STFC-DDG/cosmic-ray-cube/Scintillator_geometry.pdf

300 mm
11.81 ”

10 mm
0.39 ”

230 mm
9.06 ”

60 mm
2.36 ”

1 mm
0.039 ”

1 mm
0.039 ”

300 mm
11.81 ”

60 mm
2.36 ”

230 mm
9.06 ”

60 mm
2.36 ”
