STFC-DDG/cosmic-ray-cube/PCB_Files/Control_board_V1-PC3860M1-Prototype/pc3860m1_BOM_Build_1.xlsx

TITLE: BILL OF MATERIALS
DESIGN: pc3860m1
BUILD No.: 1
DATE: 08/08/2023
NO. OF BOARDS REQD: 2 |  | Do Not Purchase - to be fitted at Rutherford Labs
All Components to be RoHS Compliant:
Please Read Comments Column:
Part Numbers may refer to Cut-tape, reel or other packaging options. Please purchase the packaging option best suited to your assembly process and this build:
Line No. | Part Number | Part Description | Ref Des | Board Qty | Build Qty | Use Exact Part | Use Equiv. Part | Equivalent Part Number | Comments
1 | Murata GRM155R71C104KA88J | 100nF SMD Capacitor, 0402, X7R Dielectric, 16V, 10% | C128-C131,C133-C185,C202-C209,C212,C216,C220,C224,C228,C232,C236,C240 | 73 | 146 |  |  |  | Available from DigiKey 490-6328-1-ND
2 | AVX 08055C474KAT2A | 470nF SMD 50V X7R Capacitor, 0805, 10% | C18-C25 | 8 | 16 |  |  |  | Available from Farnell 1657935
3 | Kemet C0805C105K5RACTU | 1uF X7R 50V SMD Capacitor, 0805, 10% | C1-C8,C17,C30,C50,C52,C54,C61,C251-C258 | 22 | 44 |  |  |  | Available from RS 802-9942
4 | Farnell 498-543 | 22pF NPO Capacitor, 0603, 50V, +/-5% | C243-C250 | 8 | 16 |  |  |  | -
5 | Murata GRM155R71H103KA88D | 10nF SMD Capacitor, 0402, X7R Dielectric, 50V, 10% | C26,C29,C56,C211,C215,C219,C223,C227,C231,C235,C239 | 11 | 22 |  |  |  | Available from Farnell 1828887
6 | AVX 0603ZD106MAT2A | 10uF SMD Capacitor, 0603, X5R Dielectric, 10V, 20% | C27,C28,C57,C186-C193,C214,C218,C222,C226,C230,C234,C238,C242 | 19 | 38 |  |  |  | Available from Farnell 1867954
7 | Yageo CC0402KRX7R8BB472 | 4.7nF SMD Capacitor, 0402, X7R Dielectric, 25V, 10% | C31-C38 | 8 | 16 |  |  |  | Available from Farnell 3019317
8 | Taiyo Yuden EMK325ABJ107MM-T | 100uF X5R 16V Ceramic Capacitor, 1210, 20% | C39 | 1 | 2 |  |  |  | Available from DigiKey 587-3152-1-ND
9 | AVX 0603YC105KAT2A | 1uF SMD Capacitor, 0603, X7R Dielectric, 16V, 10% | C40-C48,C132,C194-C201,C210,C213,C217,C221,C225,C229,C233,C237,C241 | 27 | 54 |  |  |  | Available from Farnell 1658870
10 | AVX-KYOCERA TAJC476K016R | 47uF SMD 16V Tantalum Capacitor, Case Size C, 10% | C49 | 1 | 2 |  |  |  | Available from Farnell 197-324
11 | Farnell 498-798 | 10uF SMD Tantalum Capacitor, Case Size C, 20V, 10% | C51,C60 | 2 | 4 |  |  |  | -
12 | AVX-KYOCERA TAJA105K016R | 1uF SMD 16V Capacitor, Case Size A, 10% | C53 | 1 | 2 |  |  |  | Available from Farnell 498-701
13 | Kemet C0805C104K5RAC | 100nF SMD Capacitor, 0805, X7R Dielectric, 50V, 10% | C55,C58,C80-C95 | 18 | 36 |  |  |  | Available from RS 2644416
14 | Panasonic EEH-ZK1E561UP | 560uF 25V Aluminium Electrolytic Capacitor, ZKU Series, 20% | C59 | 1 | 2 |  |  |  | Available from DigiKey P124996CT-ND
15 | Murata GRM1555C1H331JA01D | 330pF 50V SMD Capacitor, 0402, +/-5%, C0G/NP0, GRM Series | C62 | 1 | 2 |  |  |  | Available from Farnell 8819653
16 | Sanyo 6TPE330MIL | 330uF Polymer Capacitor, 7343 Case, TPE Series Low ESR | C63 | 1 | 2 |  |  |  | Available from DigiKey P16250CT-ND
17 | Murata GRM21BR61A476ME15L | 47uF X5R 10V +/-20% SMD Capacitor, 0805 | C64-C79 | 16 | 32 |  |  |  | Available from Farnell 2611939
18 | Farnell 3019160 | 10pF NPO Capacitor, 0402, 5% | C9-C16 | 8 | 16 |  |  |  | -
19 | Micro Commercial Co MBR0540-TP | 500mA 40V SMD Schottky Power Diode | D1-D16 | 16 | 32 |  |  |  | Available from DigiKey MBR0540TPMSCT-ND
20 | Littelfuse 0453 005. | 5A Surface Mount Fuse, 453 Series | FS1 | 1 | 2 |  |  |  | -
21 | Abracon Coporation ASMPH-0603-1R5M-T | 1.5uH SMD Multilayer Chip Power Inductor 20% 900mA | L17 | 1 | 2 |  |  |  | Available from Digikey 535-12264-1-ND
22 | Murata Electronics BLM21BD222SN1L | 2.25K 250mA Ferrite Bead Inductor | L1-L8 | 8 | 16 |  |  |  | Available from DigiKey 490-9710-1-ND
23 | Murata LQH32CN470K53L | 47uH Chip Inductor, 10%, 170mA, 1210 | L9-L16 | 8 | 16 |  |  |  | Available from DigiKey 490-4063-1-ND
24 | Harwin M20-999 03 45 | Harwin Straight 3 pin Header | PL18,PL19 | 2 | 4 |  |  |  | Can be cut from M20-999 36 45
25 | Molex 22-05-1032 | Right-Angle 3 pin Header with friction lock | PL1-PL8 | 8 | 16 |  |  |  | Available from Farnell 9731016
26 | Molex 26-48-2036 | 3.96mm Pitch, 3 Way Right Angle Friction Lock Header, KK Series, PTH | PL20-PL35 | 16 | 32 |  |  |  | Available from Mouser 538-26-48-2036
27 | Harwin M20-999 02 45 | Harwin Straight 2 pin Header, 0.1 inch pitch | PL9-PL17 | 9 | 18 |  |  |  | Can be cut from M20-999 36 45
28 | Farnell 9239316 | 4K7 SMD Resistor, 0.063W, 0402, 1% | R121-R128 | 8 | 16 |  |  |  | -
29 | Multicomp MC00625W04021150K | 150K SMD Resistor, 0.063W, 0402, 1% | R138,R140,R142,R144,R146,R148,R150,R152 | 8 | 16 |  |  |  | Available from Farnell 1358100
30 | Panasonic ERJ2RKF2490X | 249R SMD Resistor, 0.1W, 0402, 1% | R153-R160 | 8 | 16 |  |  |  | Available from Farnell 2059120
31 | Multicomp MCSR04X1001FTL | 1K0 SMD Resistor, 0.063W, 0402, 1% | R1-R8,R75 | 9 | 18 |  |  |  | Available from Farnell 2073959
32 | Yageo RC0402FR-07100KL | 100K SMD Resistor, 0.063W, 0402, 1% | R25-R40 | 16 | 32 |  |  |  | Available from Farnell 9239472
33 | Yageo RC0603FR-0713KL | 13k0 SMD Resistor, 0.1W, 0603, 1%, 75V | R41 | 1 | 2 |  |  |  | Available from Farnell 3495737
34 | TE Connectivity CPF0603B40K2E1 | 40K2 SMD Resistor, +/-25ppm/Deg C,0.063W, 0603, 0.1%,50V | R42 | 1 | 2 |  |  |  | Available from Farnell 2331207
35 | Multicomp MCWR04X1000FTL | 100R SMD Resistor, 0.063W, 0402, 1% | R43-R50 | 8 | 16 |  |  |  | Available from Farnell 2447095
36 | Farnell 9331379 | 560K SMD Resistor, 0.063W, 0603, 1% | R67-R74 | 8 | 16 |  |  |  | -
37 | Farnell 1170731 | 280R SMD Resistor, 0.063W, 0603, 1% | R76 | 1 | 2 |  |  |  | -
38 | Farnell 9239120 | 120R SMD Resistor, 0.063W, 0402, 1% | R96 | 1 | 2 |  |  |  | -
39 | Multicomp MCMR04X1002FTL | 10K SMD Resistor, 0.063W, 0402, 1% | R9-R24,R51-R66,R77-R95,R129-R137,R139,R141,R143,R145,R147,R149,R151 | 67 | 134 |  |  |  | Available from Farnell 2072517
40 | Bourns 3266W-1-104LF | 100K, 3266W Variable Resistor, 0.25W | RV1-RV8 | 8 | 16 |  |  |  | Available from Farnell 9352660
41 | Farnell 9352759 | 5K0, 3266W Variable Resistor, 0.25W | RV9,RV10 | 2 | 4 |  |  |  | -
42 | NorComp 820BR02-213R001 | 2 Position Circular Connector Receptacle, Female Sockets Solder, 820B Series | SK1 | 1 | 2 |  |  |  | Available from DigiKey NOR1502-ND
43 | Keystone 5001 | Black Miniture Through Hole Mount Test Point | TP1-TP7 | 7 | 14 |  |  |  | Available from DigiKey 36-5001-ND
44 | Philips BC850B | General Purpose Switching NPN Transistor | TR1-TR8 | 8 | 16 |  |  |  | Available from Farnell 1081239
45 | Linear Technology LT1962EMS8-5 | 300mA Low Noise LDO Regulator, 5V | U1,U18 | 2 | 4 |  |  |  | -
46 | Analogue Devices ADP7105ACPZ-R7 | Low Noise LDO Adjustable Regulator with Soft Start, 20Vin, 1.22V to 19V out, 500mA | U19 | 1 | 2 |  |  |  | Available from Mouser 584-ADP7105ACPZ-R7
47 | Linear Technology LT3461AES6#TRMPBF | 3MHz Step-Up DC/DC Converter with Integrated Schottky | U2,U4,U6,U8,U10,U12,U14,U16 | 8 | 16 |  |  |  | Available from DigiKey 505-LT3461AES6#TRMPBFCT-ND
48 | STMicroelectronics TS391ILT | Low-Power Single Voltage Comparator | U20-U27 | 8 | 16 |  |  |  | Available from Farnell 1467689
49 | Microchip MCP33141-10-E/MS | 1Msps/500ksps, 12-Bit Single-Ended Input SAR ADC | U28-U35 | 8 | 16 |  |  |  | Available from Mouser 579-MCP33141-10-E/MS
50 | Linear Technology LT1807IS8#PBF | 325MHz, Dual, Rail-to-Rail Input and Output, Low Distortion, Low Noise Precision Op Amps | U3,U5,U7,U9,U11,U13,U15,U17 | 8 | 16 |  |  |  | Available from DigiKey LT1807IS8#PBF-ND
51 | Analog Devices ADP151ACPZ-1.8-R7 | LDO Voltage Regulator, Fixed 1.8 V/200mA out, 2.2V-5.5V in, 150mV drop | U36 | 1 | 2 |  |  |  | Available from Farnell 2727446
52 | Analog Devices REF195GSZ | 5V Voltage Reference, ROHS Compliant | U37 | 1 | 2 |  |  |  | Available from DigiKey REF195GSZ-ND
53 | Texas Instruments SN74LVC1G08DCKR | Single 2-Input Positive-AND Gate | U38-U43,U49-U54 | 12 | 24 |  |  |  | Available from Farnell 1287597
54 | Diodes Inc 74LVC1G11DW-7 | Single 3 Input Positive AND Gate | U44-U48,U55-U59 | 10 | 20 |  |  |  | Available from Farnell 1893824
55 | Linear Technology LT1962EMS8-3.3PBF | 300mA Low Noise LDO Regulator, 3V3 | U60 | 1 | 2 |  |  |  | Available from RS 919-9207
56 | NXP 74AHC1G08GW/T1 | Single 2-Input AND Gate | U61 | 1 | 2 |  |  |  | Available from Farnell 1085240
57 | Texas Instruments SN74LVC1G332DCKR | Single 3-Input Positive-OR Gate | U62-U69,U72,U73 | 10 | 20 |  |  |  | Available from Farnell 1494932
58 | Texas Instruments SN74LVC1G17DBVT | Single Schmitt-Trigger Buffer | U70 | 1 | 2 |  |  |  | Available from Farnell 1739722
59 | Nexperia USA Inc. 74LVCH1T45GW-Q100H | Dual Supply Translating Transceiver, 3-State | U71,U74 | 2 | 4 |  |  |  | Available from DigiKey 1727-74LVCH1T45GW-Q100HCT-ND
60 | Texas Instruments SN74LVC1G32DCKR | Single 2 - Input Positive OR Gate | U75 | 1 | 2 |  |  |  | Available from Farnell 1470880
61 | Texas Instruments SN74LVC1G74DCUR | Single Positive-Edge-Triggered D-Type Flip-Flop with Clear and Preset | U76,U77 | 2 | 4 |  |  |  | Available from Farnell 2295725
62 | Texas Instruments SN74LVC1G04DBVR | Single Inverter Gate | U78 | 1 | 2 |  |  |  | Available from Farnell 3006604
63 | Texas Instruments PTH12060WAD | 10A, 12V Input Non-Isolated Wide-Output Adjust Power Module, PTH | U79 | 1 | 2 |  |  |  | Available from Mouser 595-PTH12060WAD
64 | PJRC TEENSY40 | Teensy 4.0 Microcontroller | U80,U82 | 2 | 4 |  |  |  | Available from The Pi Hut SKU: 103087 - DO NOT PURCHASE
65 | Adafruit 5400 | ESP32 Feather V2.0 Microcontroller | U81 | 1 | 2 |  |  |  | Available from The Pi Hut ADA5400 - DO NOT PURCHASE
66 | Texas Instruments SN74AVC8T245PWR | 8-Bit Dual-Supply Bus Transceiver With Configurable Voltage Translation and 3-State Outputs | U83,U84 | 2 | 4 |  |  |  | Available from DigiKey 296-33827-5-ND
67 | Maxim Integrated / Analog Devices MAX13443EASA+ | +/-15kV ESD-Protected, +/-80V Fault-Protected, Fail-Safe RS-485/J1708 Transceiver | U85 | 1 | 2 |  |  |  | Available from Farnell 2511397
