STFC-DDG/cosmic-ray-cube/PCB_Files/SiPM_board-PC3867M1/pc3867p1_BOM_Build_1.xlsx

TITLE: BILL OF MATERIALS
DESIGN: pc3867p1
BUILD No.: 1
DATE: 09/08/2023
NO. OF BOARDS REQD: 10
All Components to be RoHS Compliant:
Please Read Comments Column:
Part Numbers may refer to Cut-tape, reel or other packaging options. Please purchase the packaging option best suited to your assembly process and this build:
Line No. | Part Number | Part Description | Ref Des | Board Qty | Build Qty | Use Exact Part | Use Equiv. Part | Equivalent Part Number | Comments
1 | Murata GRM155R71H103KA88D | 10nF SMD Capacitor, 0402, X7R Dielectric, 50V, 10% | C1-C4 | 4 | 40 |  |  |  | Available from Farnell 1828887
2 | Molex 22-05-1032 | Right-Angle 3 pin Header with friction lock | PL1 | 1 | 10 |  |  |  | Available from Farnell 9731016
3 | KOA RN73R1ETTP50R0F50 | 50R SMD Resistor, 0.0625W, 0402, 1%, 50V | R1-R3 | 3 | 30 |  |  |  | Available from Farnell 3544456
4 | OnSemi S10931-050P | C-Series SiPM Sensor, 6mm x 6mm 35um | U1 | 1 | 10 |  |  |  | Available from Farnell 2949095
5 | PC3867P1 | Cosmic Cube SIPM Board - Printed Circuit Board | - | 1 | 10 |  |  |  | -
