STFC-DDG/cosmic-ray-cube/3D_Print_Files/TubeCollet.stl

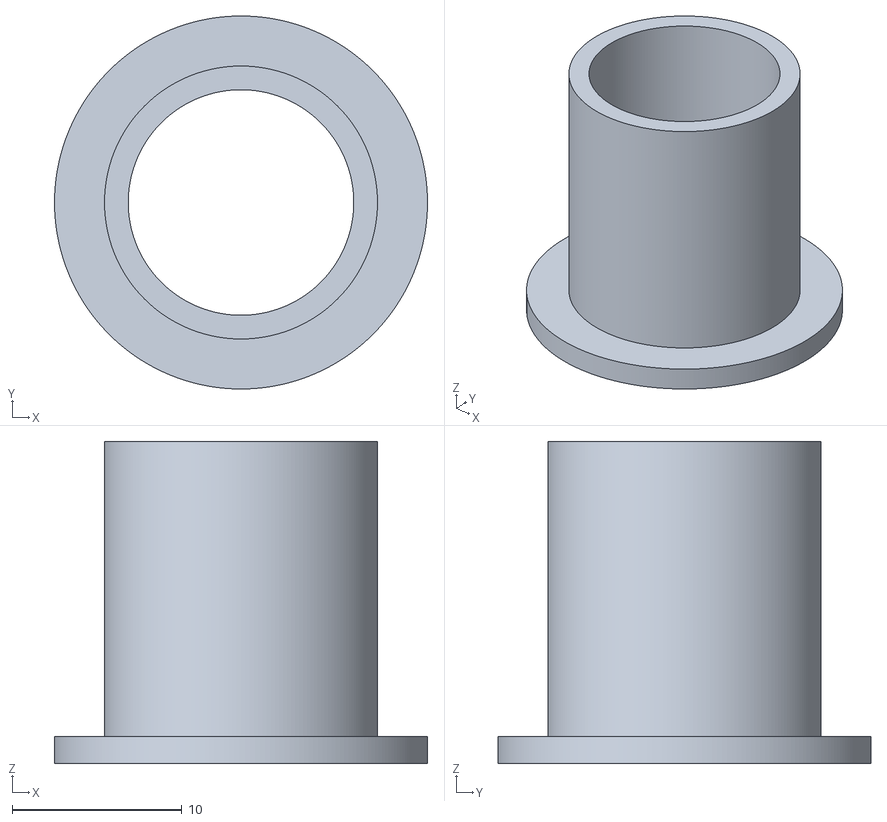
[picture p1: CAD file, 2024-02-02]
3D_Print_Files/TubeCollet.stl
22.0 x 22.0 x 19.0
