STFC-DDG/cosmic-ray-cube/3D_Print_Files/SiPM_clip.stl

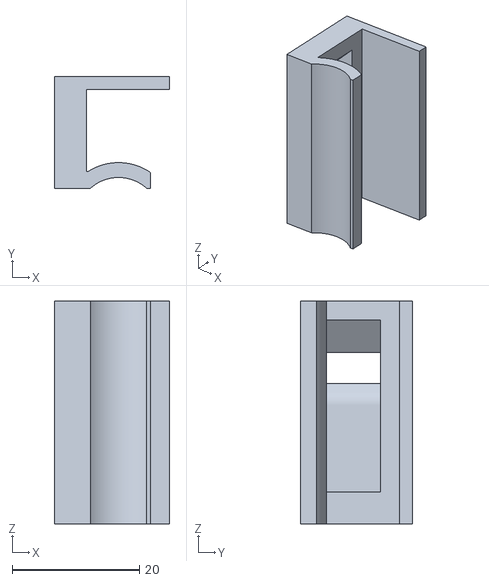
[picture p2: CAD file, 2024-02-02]
3D_Print_Files/SiPM_clip.stl
18.1 x 17.5 x 35.0
