STFC-DDG/cosmic-ray-cube/PCB_Files/Control_board_V1-PC3860M1-Prototype/pc3860m1_080823_schematic_A.pdf

## -TE-0208-011-1-A

### LT3461A

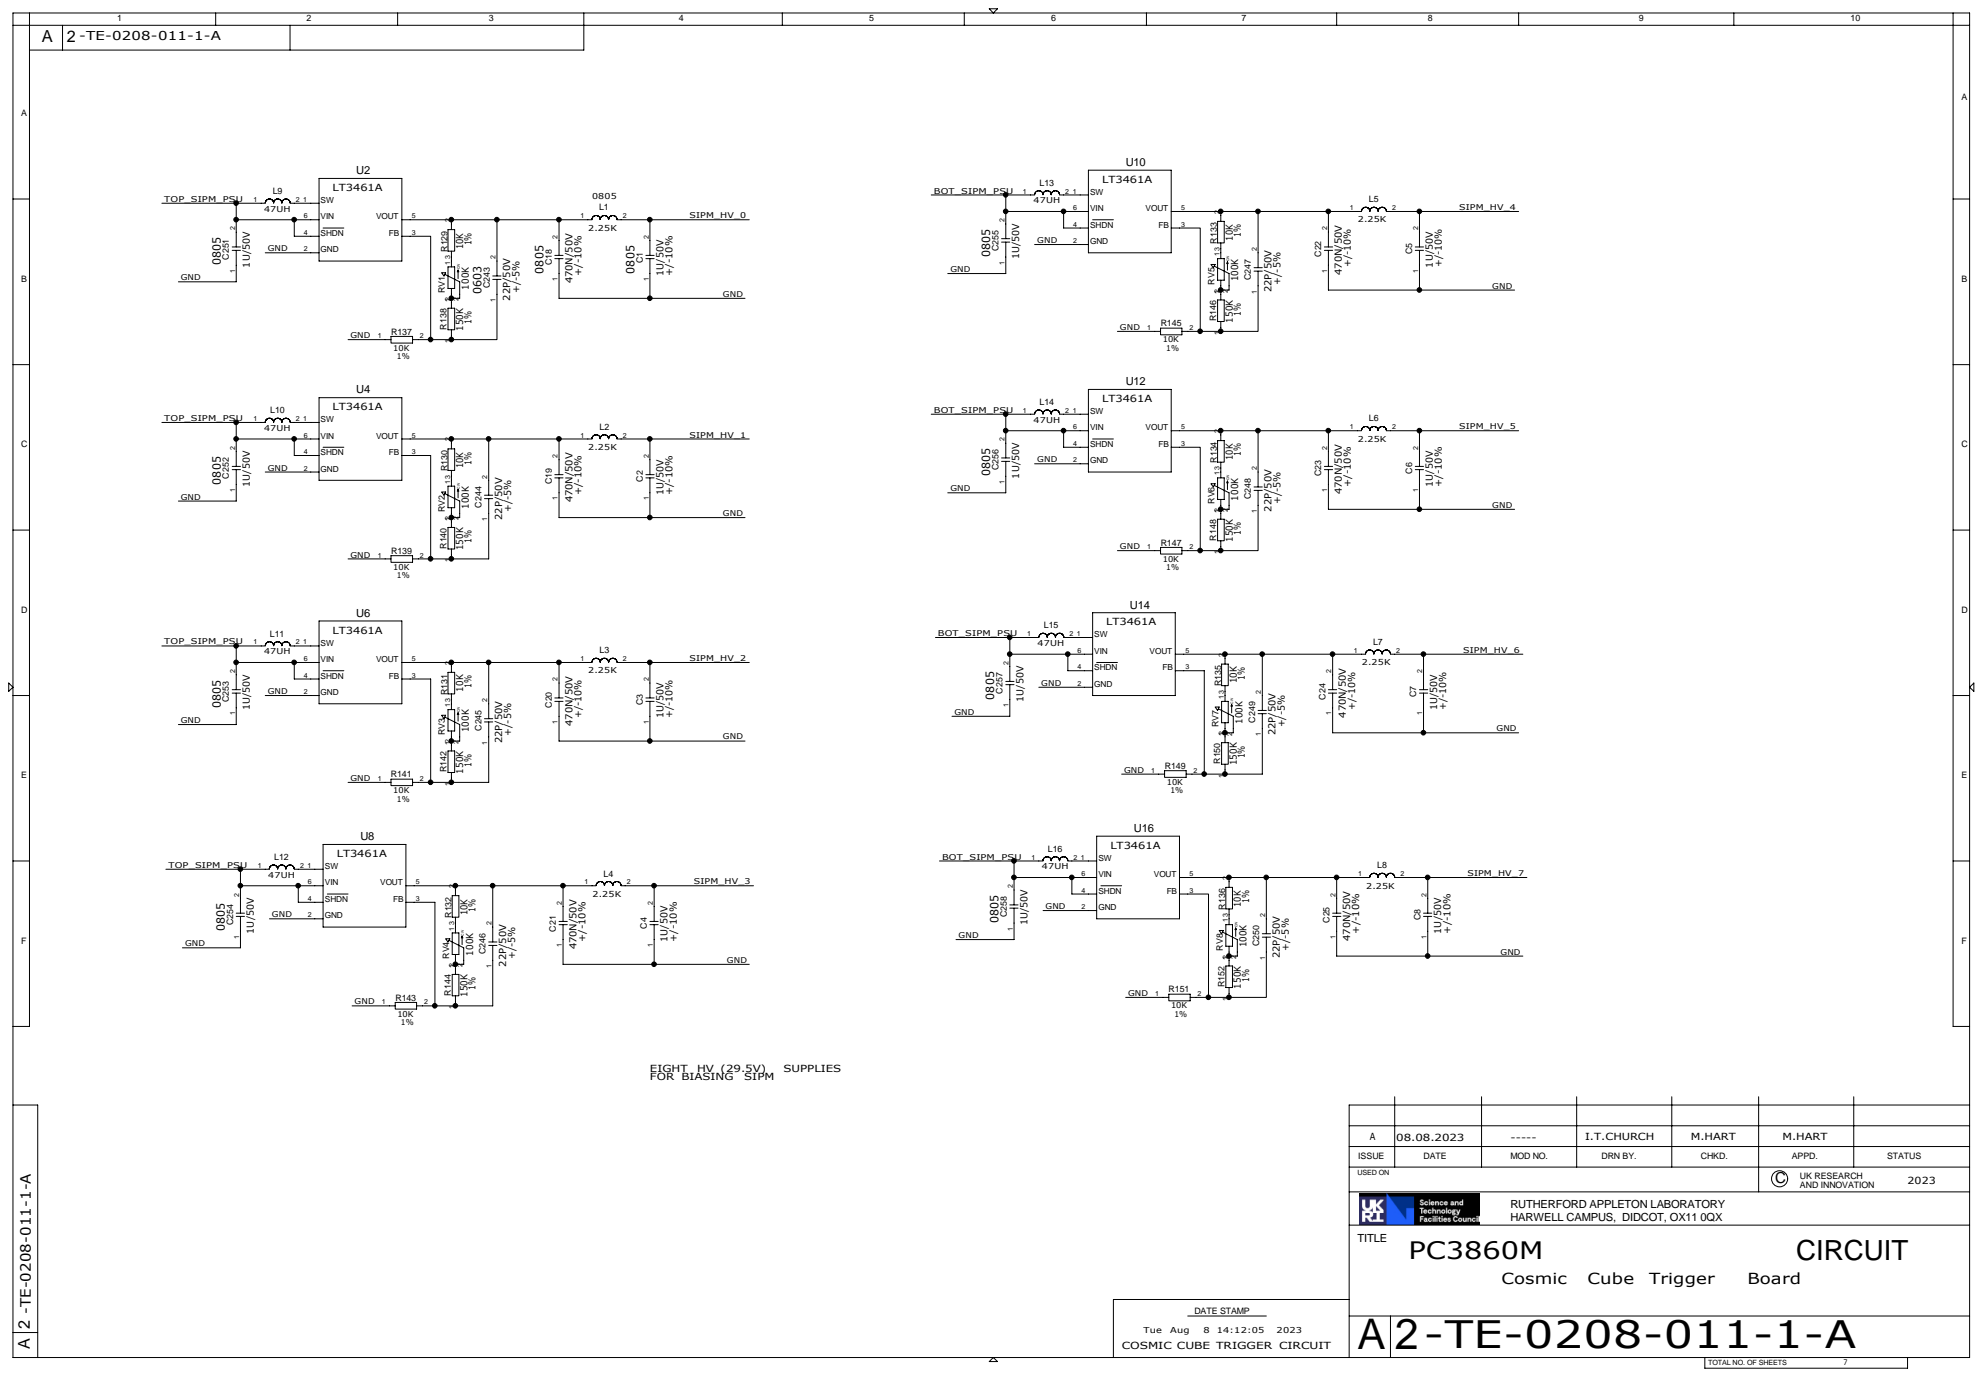
[picture p8: page 1]

COSMIC CUBE TRIGGER CIRCUIT

TOTAL NO. OF SHEETS

### TOP NORTH

### EVENT TRIGGER COMPARATORS

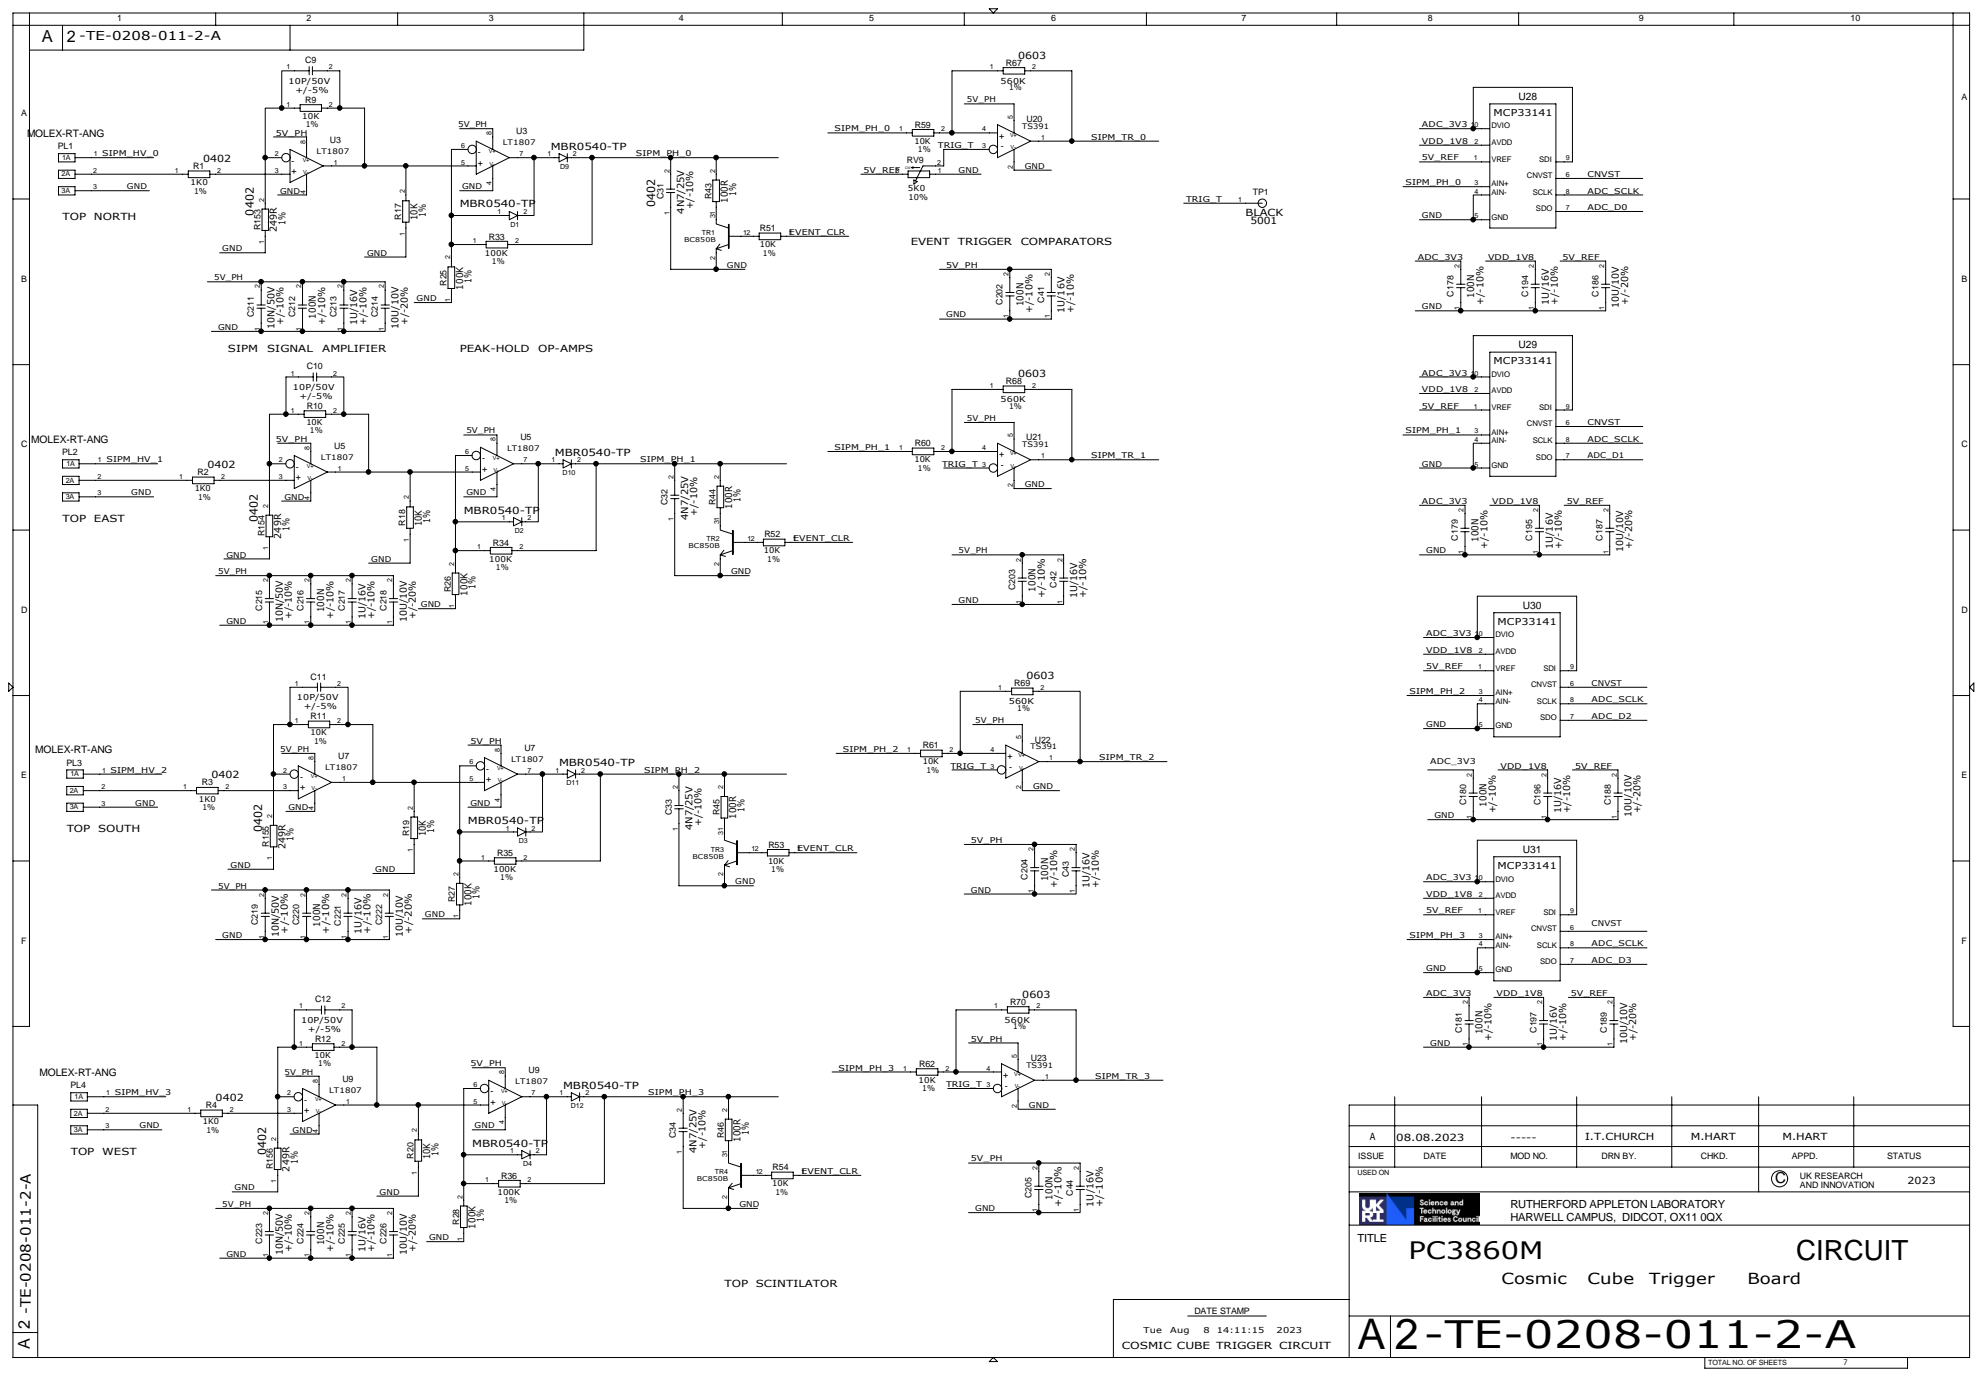
[picture p9: page 2]

### BOTTOM NORTH

## -TE-0208-011-3-A

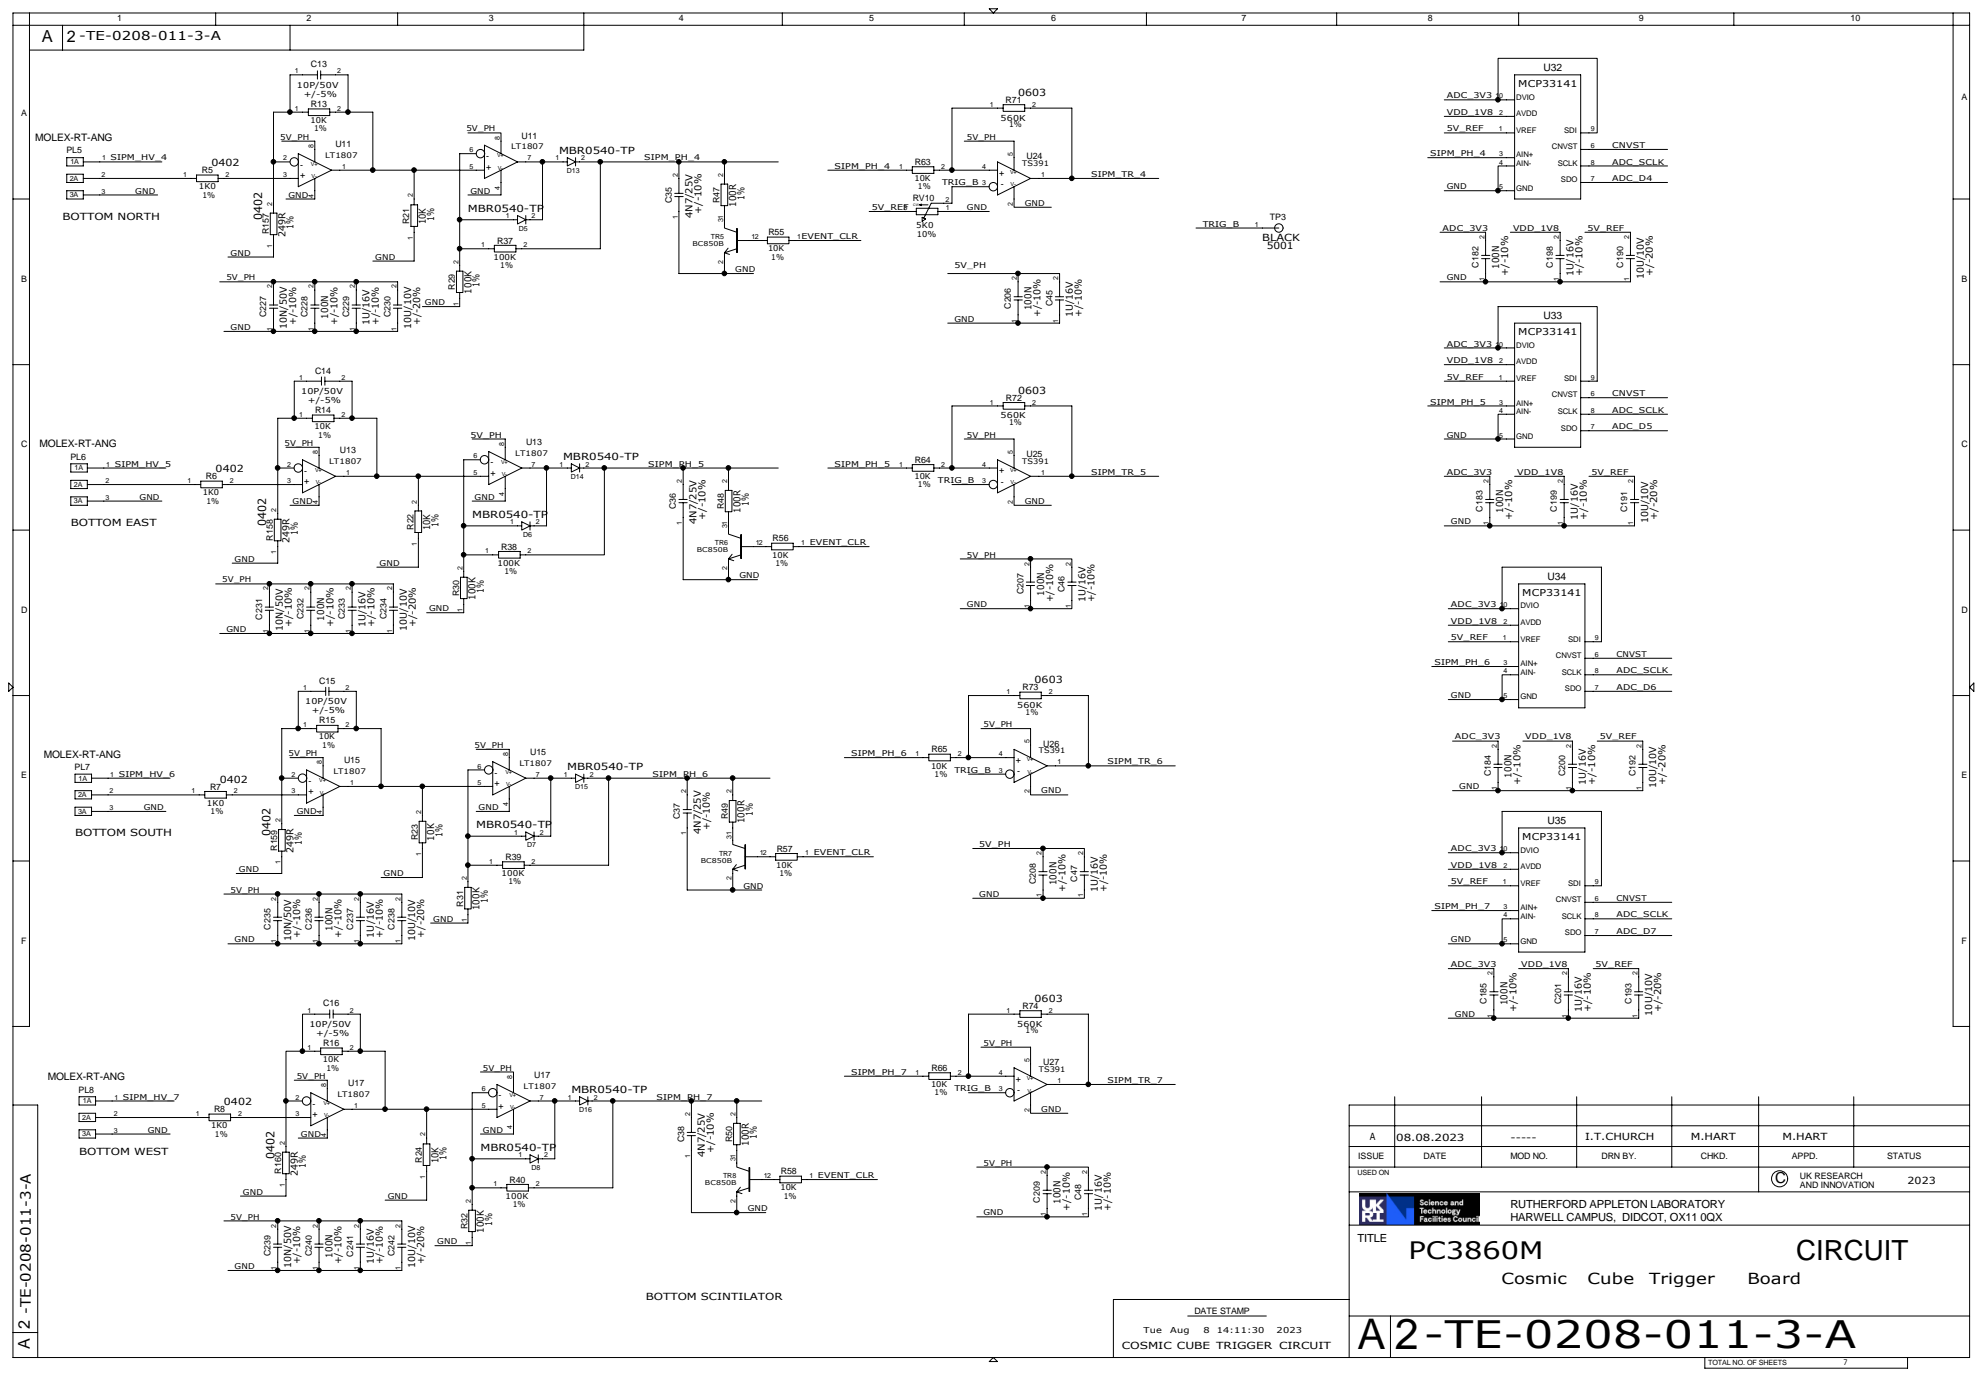
[picture p10: page 3]

0001 N

0000 N

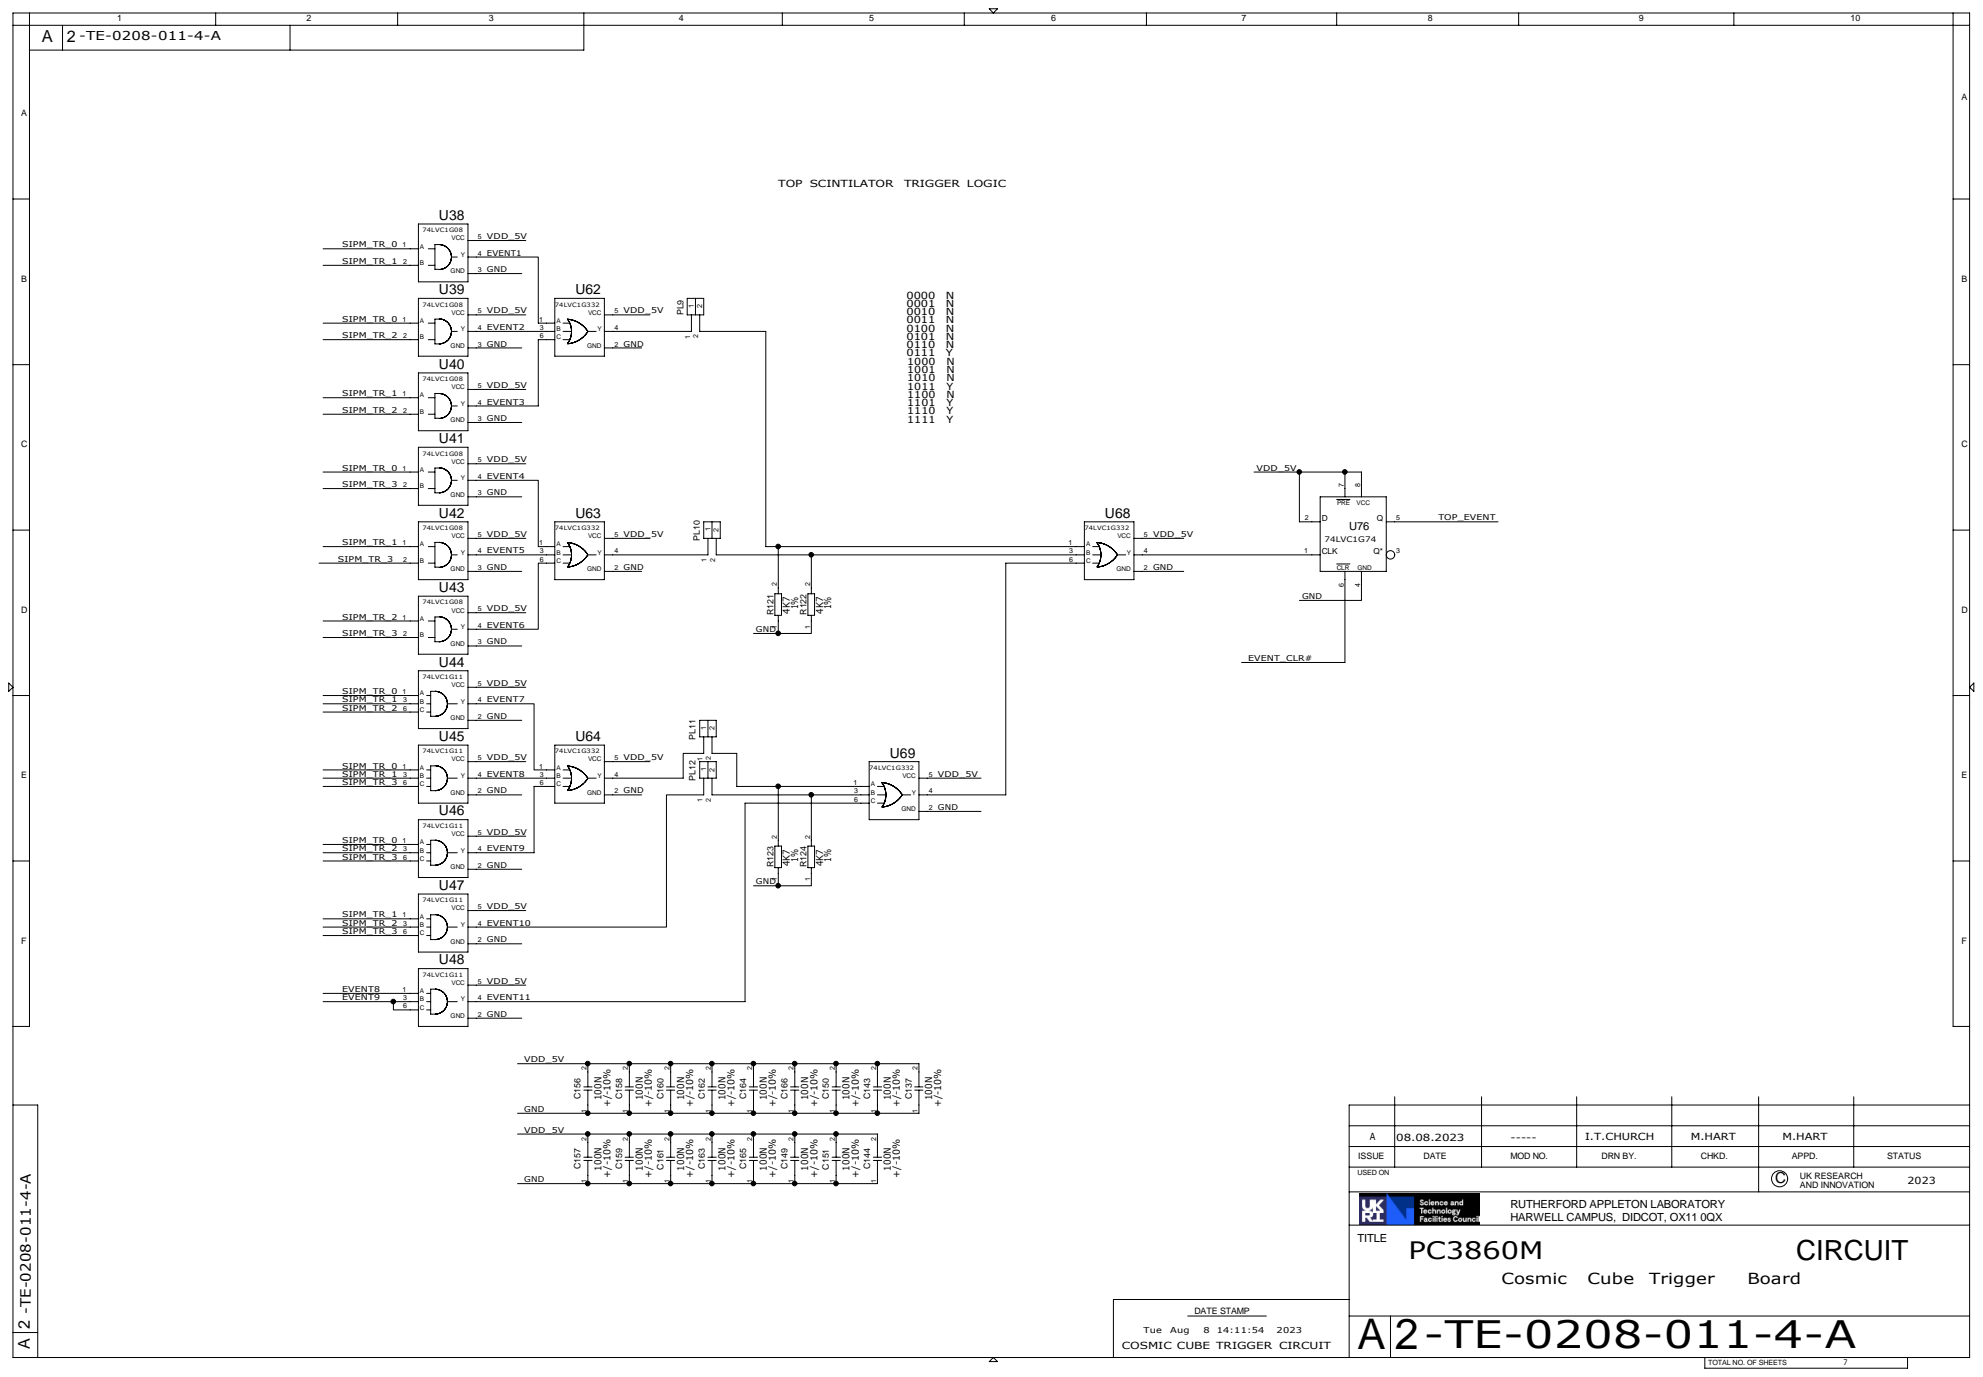
[picture p11: page 4]

TOP SCINTILATOR TRIGGER LOGIC

### BOTTOM SCINTILATOR TRIGGER LOGIC

## -TE-0208-011-5-A

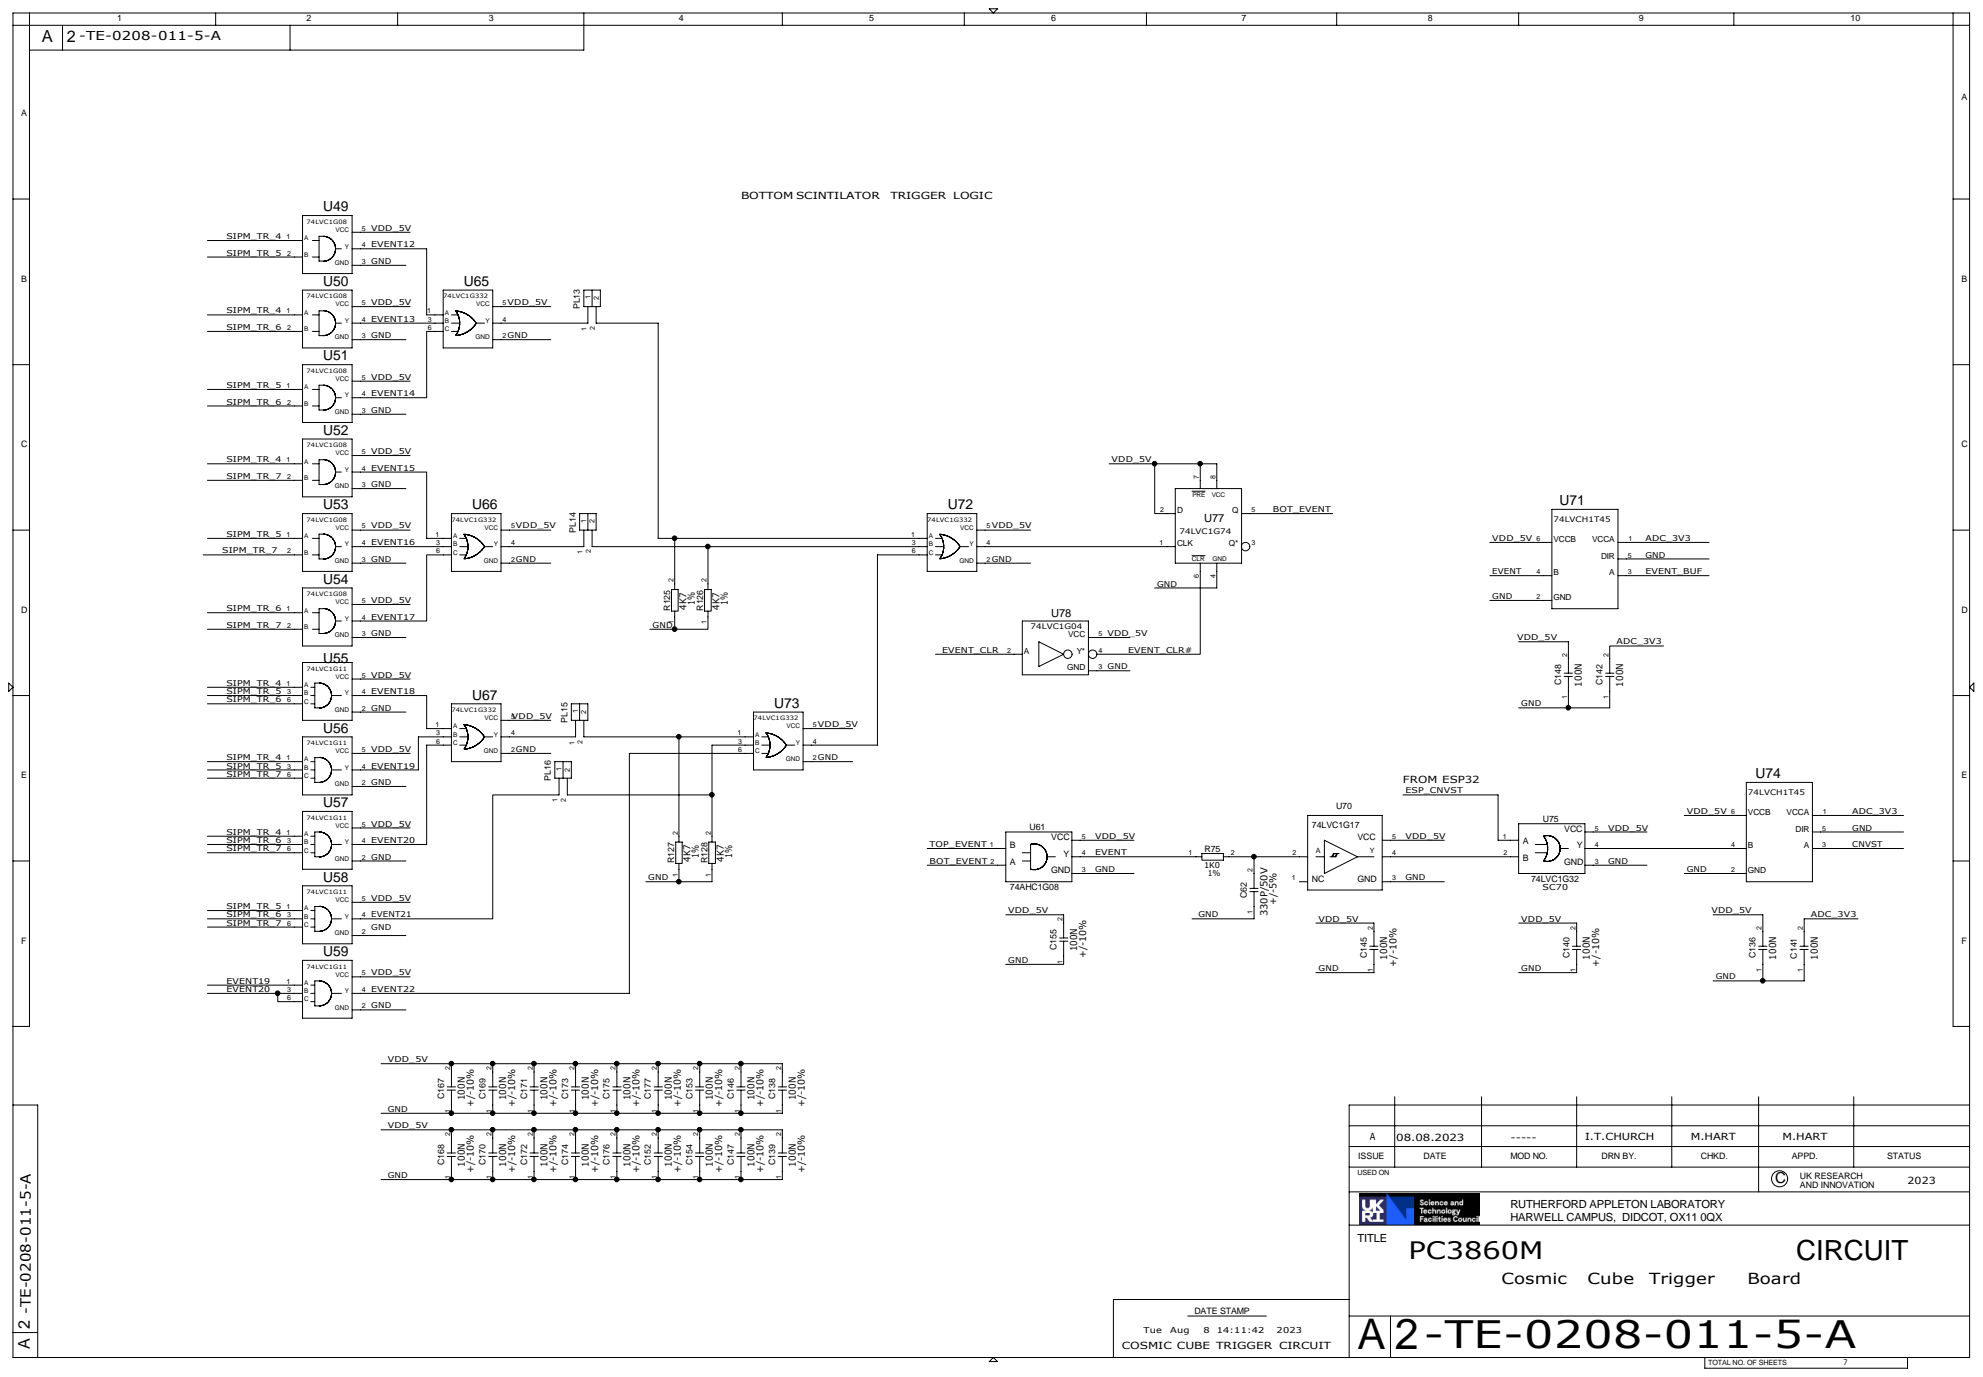
[picture p12: page 5]

### LED BRIGHTNESS POT

### HEADER FOR CONNECTION TO

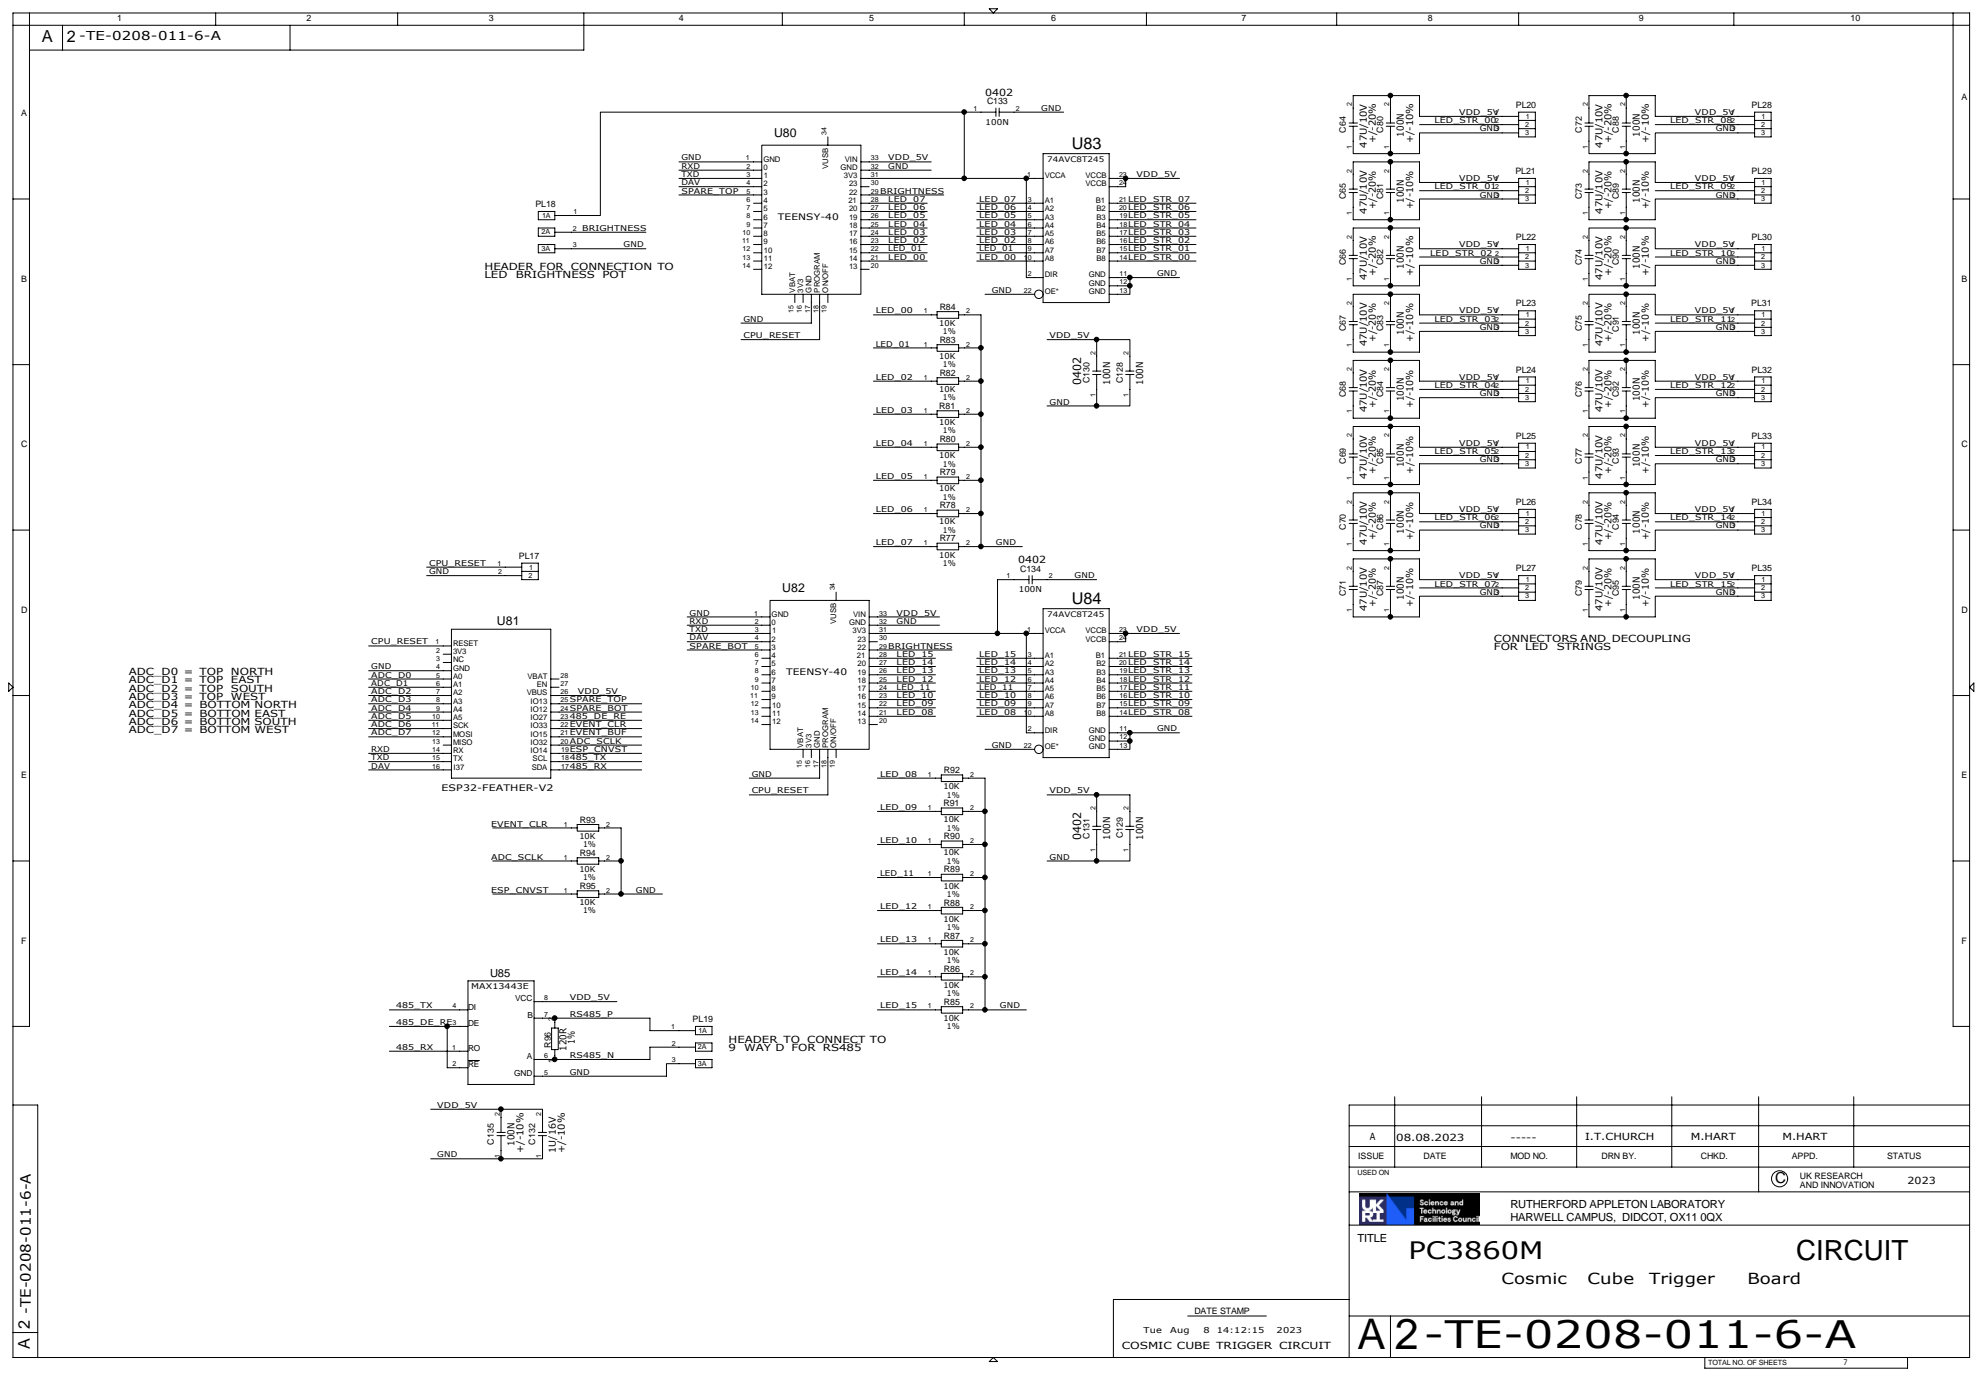
[picture p13: page 6]

HEADER TO CONNECT TO
9 WAY D FOR RS485

### 1V8 FOR ANALOGUE SIDE OF ADC

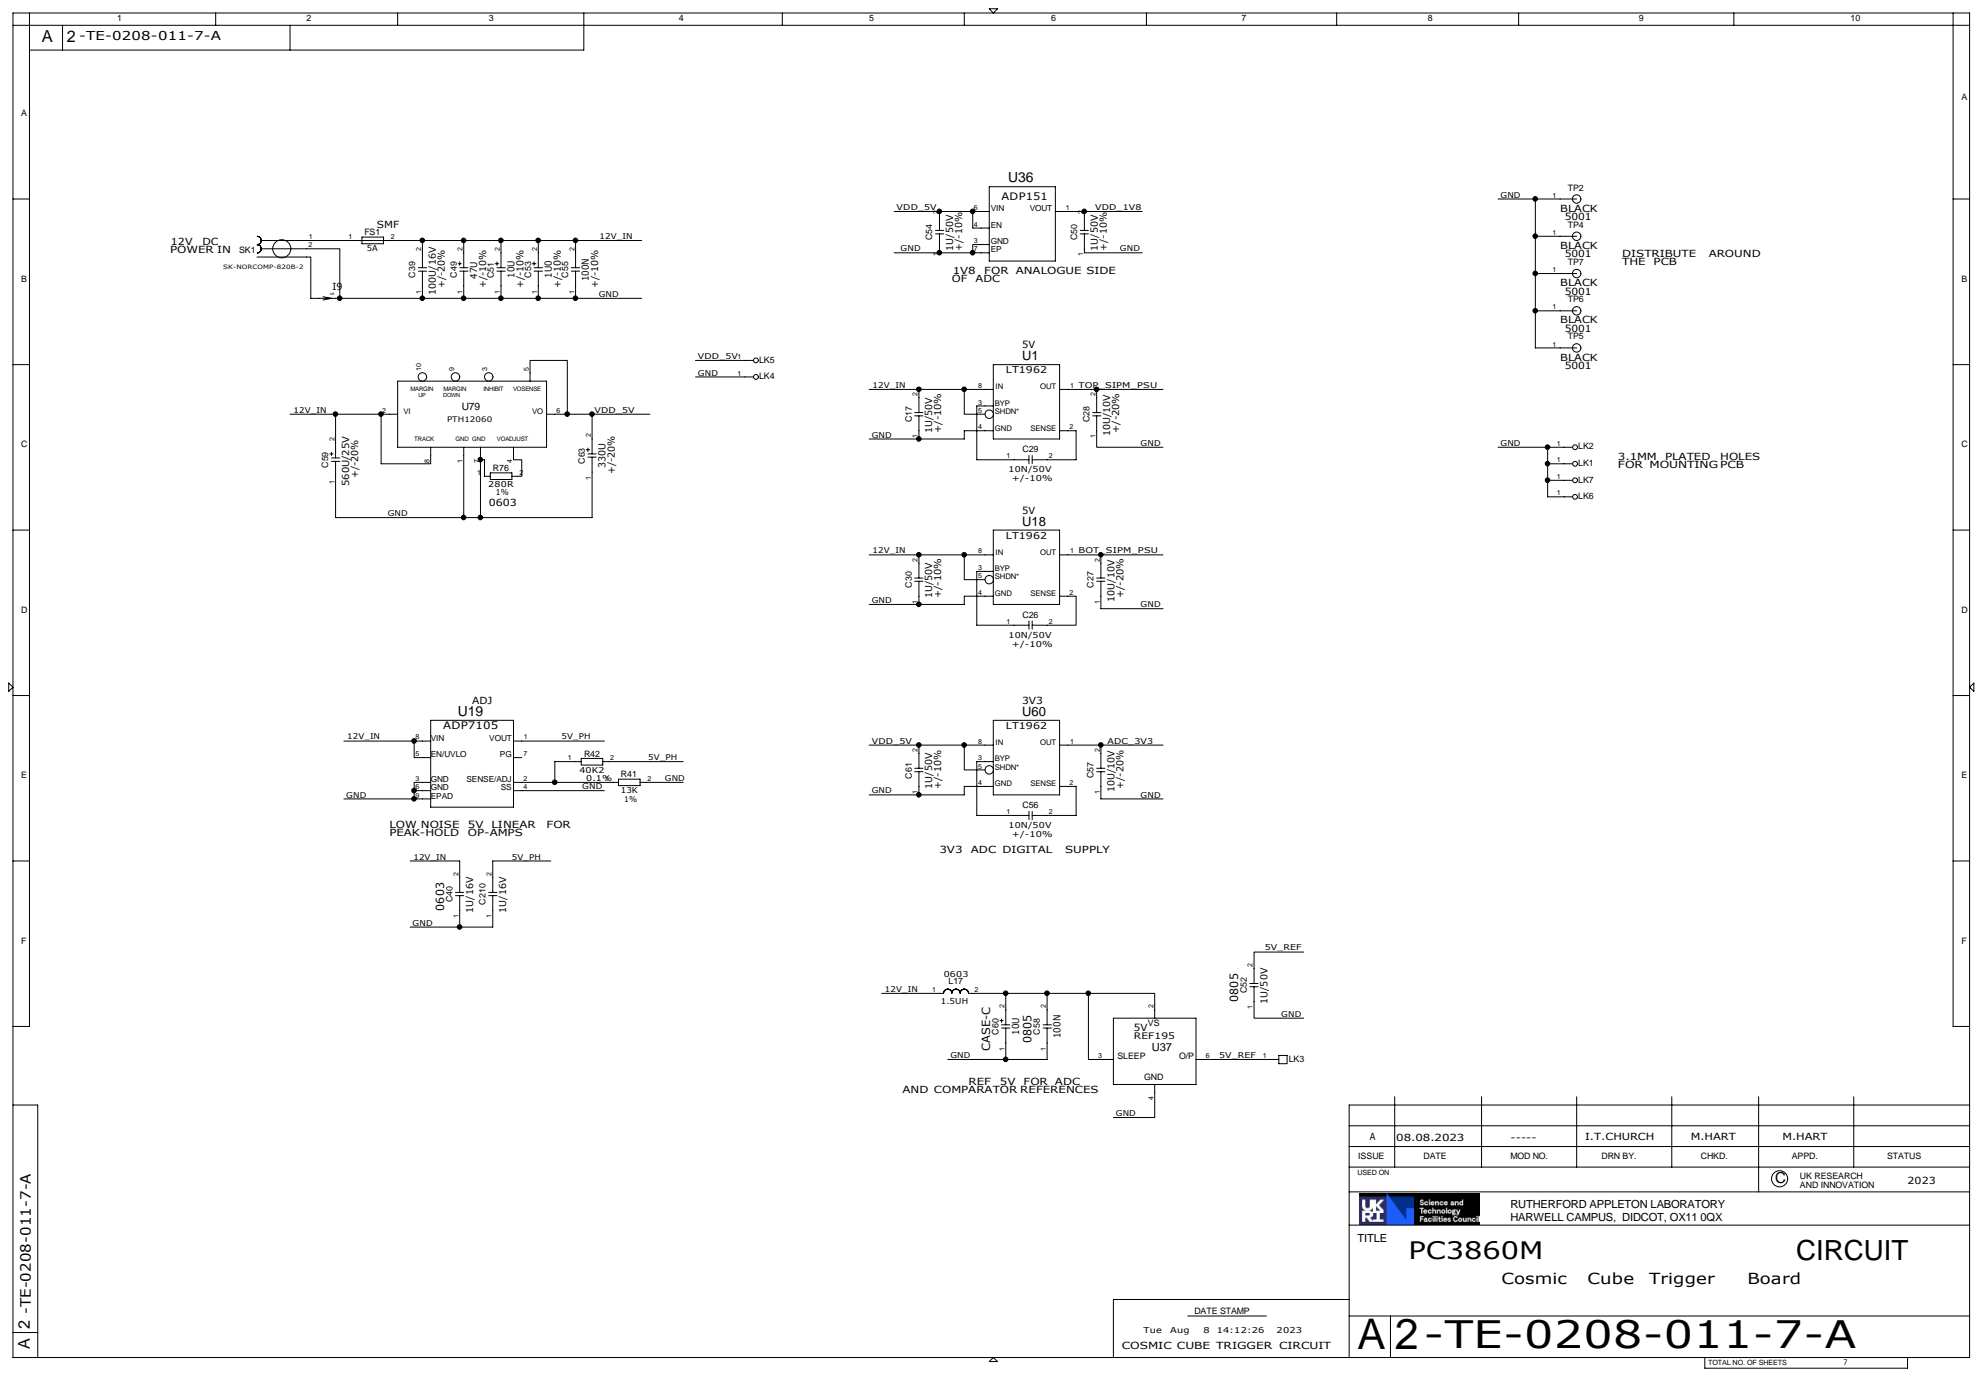
[picture p14: page 7]

LOW NOISE 5V LINEAR FOR
PEAK-HOLD OP-AMPS
