STFC-DDG/cosmic-ray-cube/PCB_Files/SiPM_board-PC3867M1/pc3867p1_Schematic_A.pdf

## -TE-0208-014-1-A

2

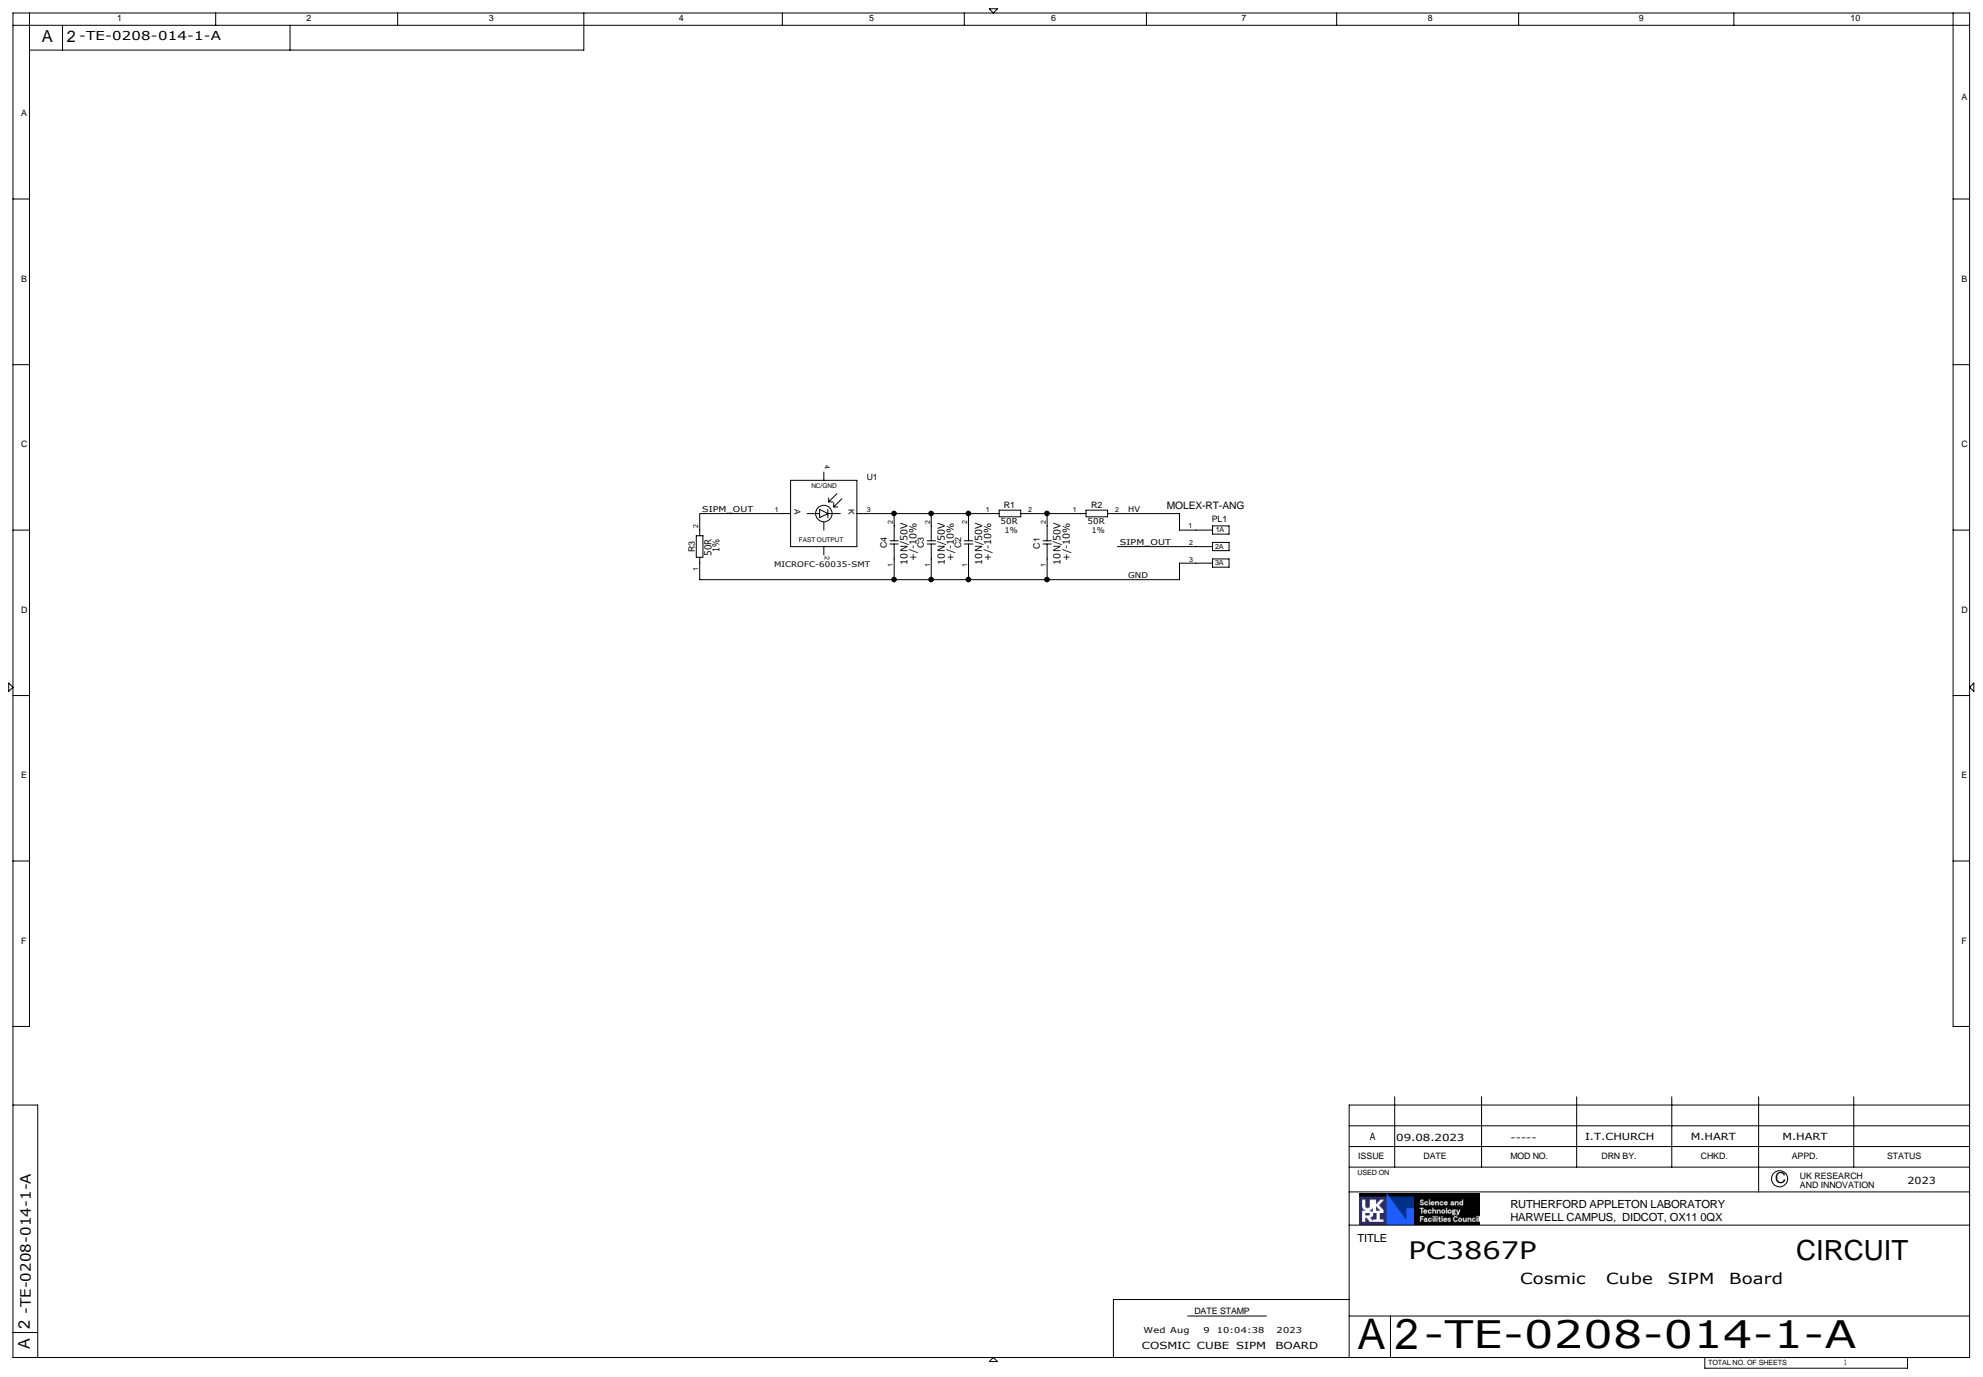
[picture p15: page 1]

Cosmic Cube SIPM Board

COSMIC CUBE SIPM BOARD

TOTAL NO. OF SHEETS
