STFC-DDG/cosmic-ray-cube/PCB_Files/Control_board_V1-PC3860M1-Prototype/pc3860m1_BottomAssembly_A.pdf

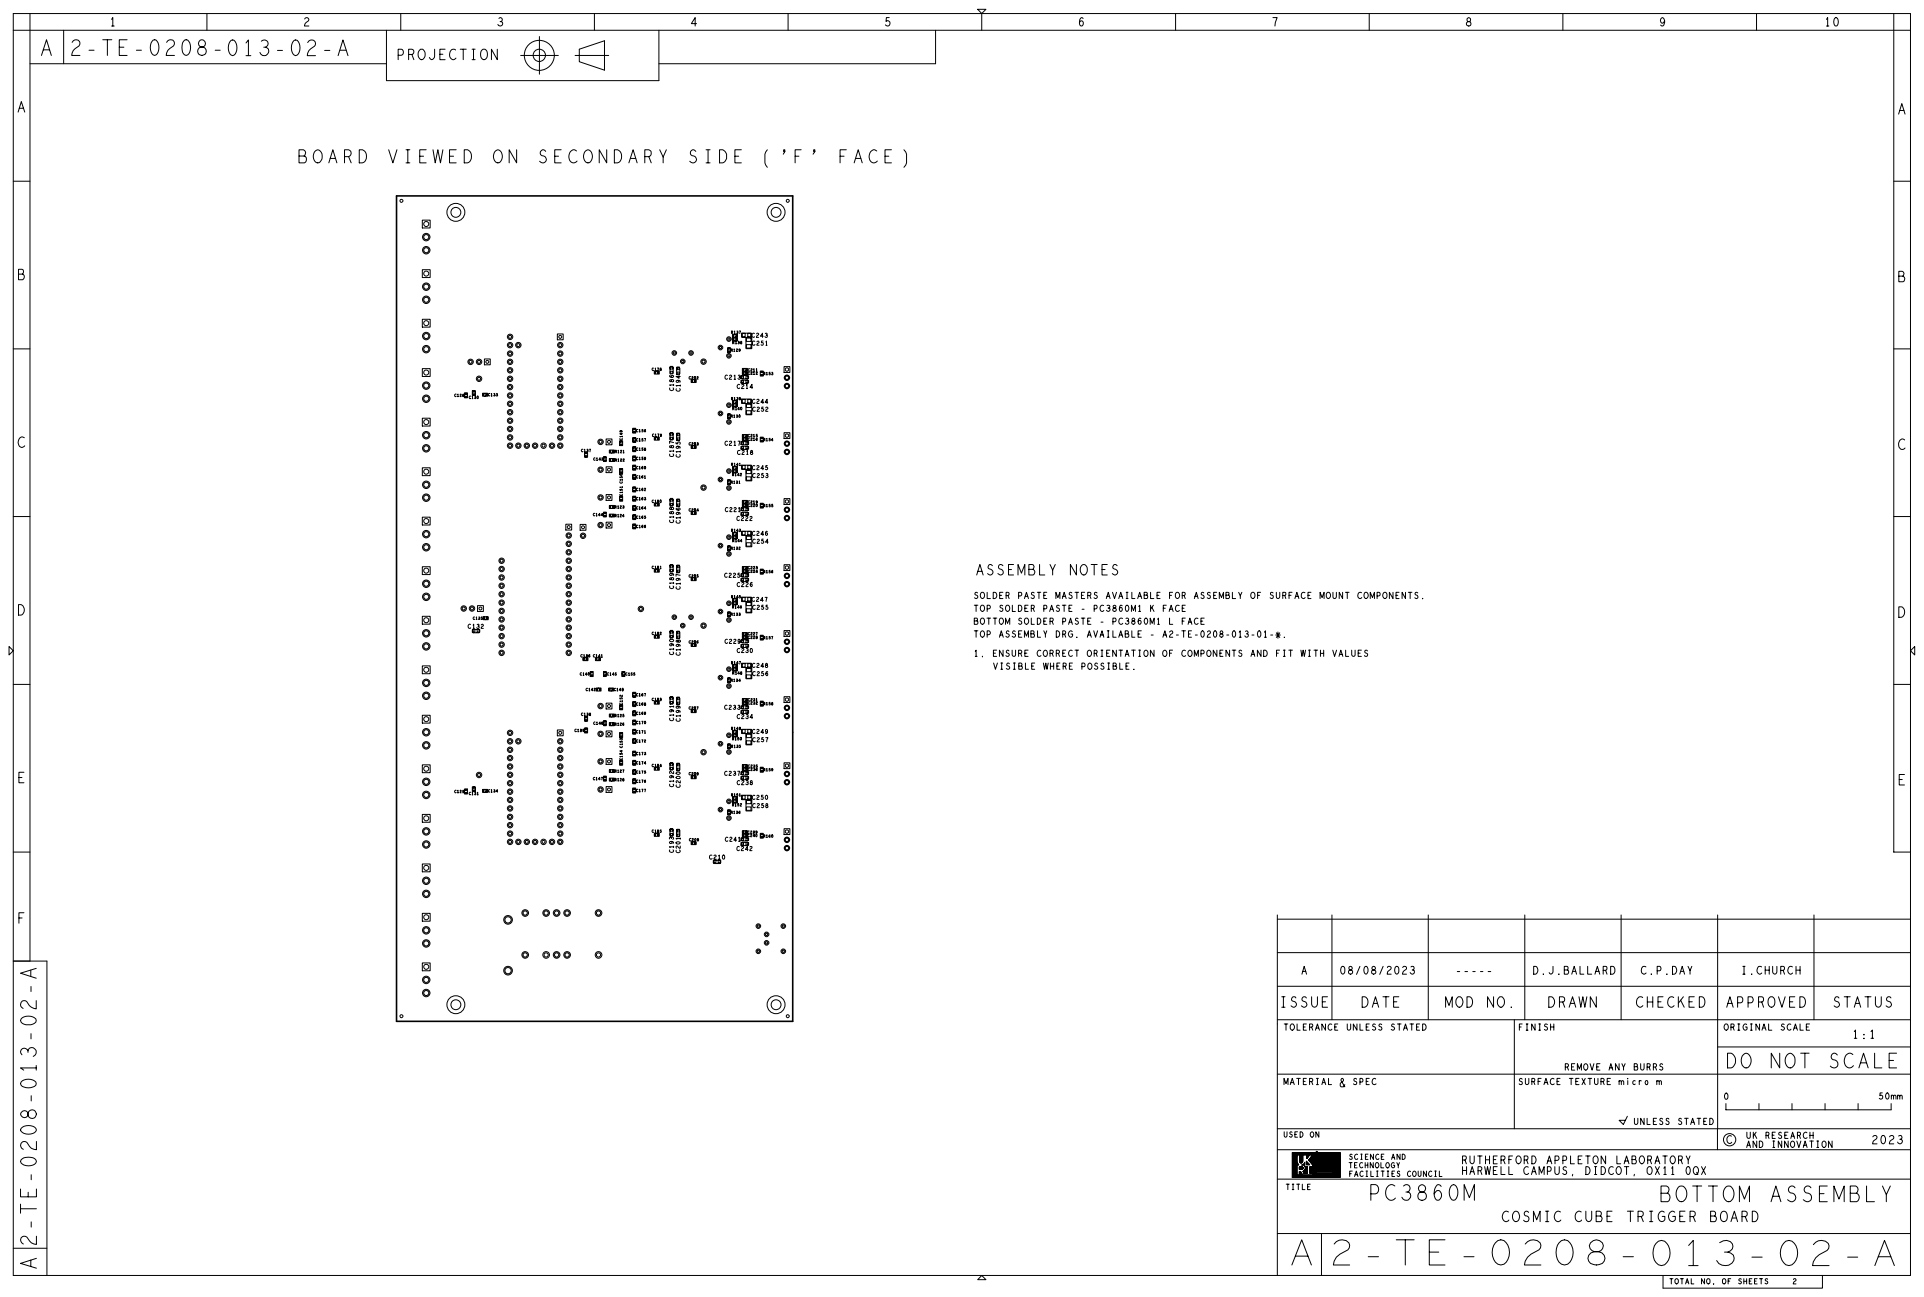
[picture p16: page 1]
