STFC-DDG/cosmic-ray-cube/PCB_Files/SiPM_board-PC3867M1/pc3867p1_Assembly_A.pdf

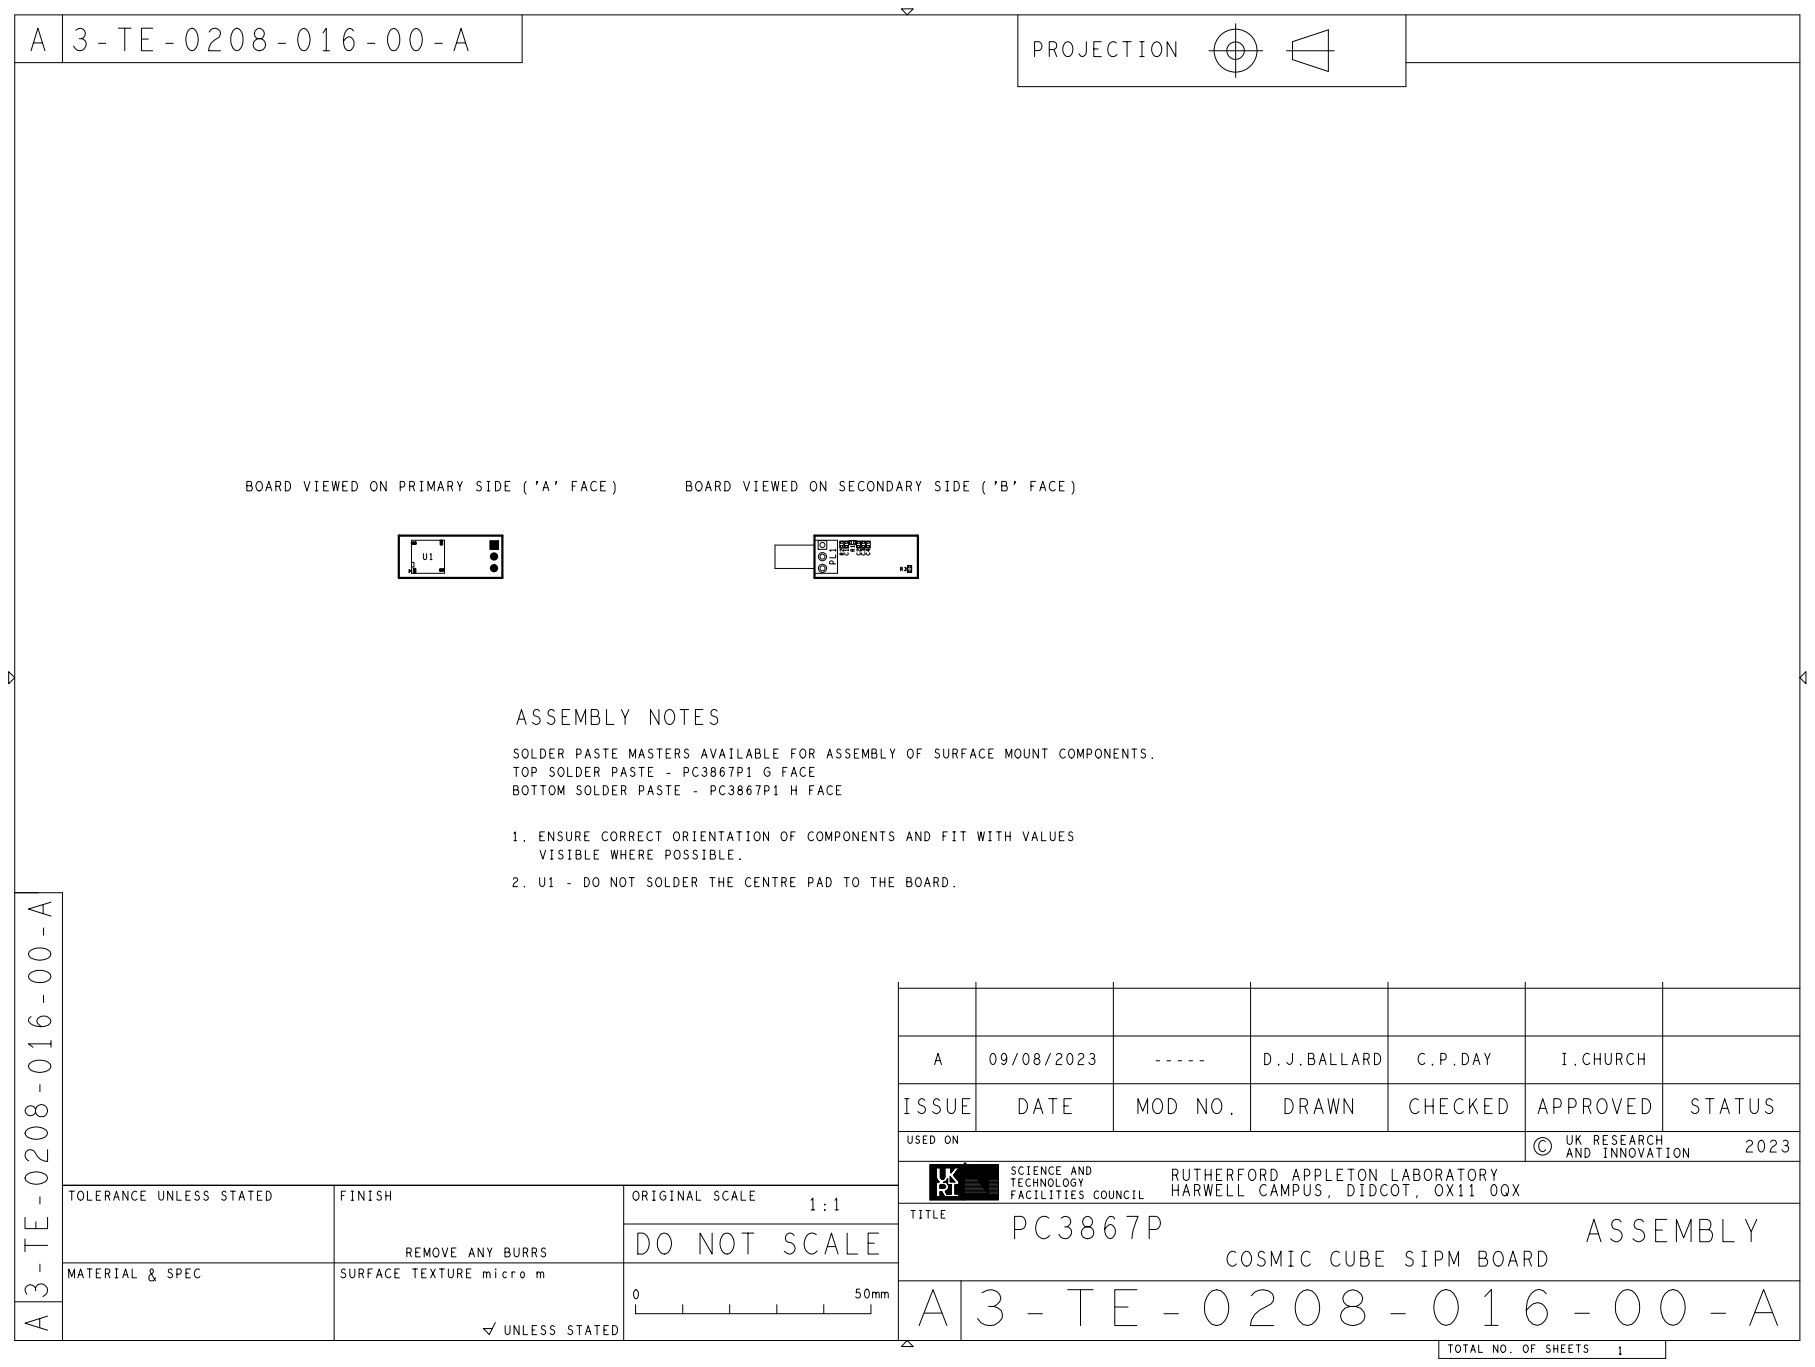
[picture p18: page 1]
