STFC-DDG/cosmic-ray-cube/Code/include/lookup_table.h

#define LOOKUP_SIZE 12
const uint16_t lookup_table[LOOKUP_SIZE][LOOKUP_SIZE] = {
{90, 95, 100, 100, 95, 90, 85, 80, 75, 70, 65, 60},
{86, 91, 96, 96, 91, 86, 81, 76, 71, 66, 61, 56},
{82, 87, 92, 92, 87, 82, 77, 72, 67, 62, 57, 52},
{78, 83, 88, 88, 83, 78, 73, 68, 63, 58, 53, 48},
{74, 79, 84, 84, 79, 74, 69, 64, 59, 54, 49, 44},
{70, 75, 80, 80, 75, 70, 65, 60, 55, 50, 45, 40},
{66, 71, 76, 76, 71, 66, 61, 56, 51, 46, 41, 36},
{62, 67, 72, 72, 67, 62, 57, 52, 47, 42, 37, 32},
{58, 63, 68, 68, 63, 58, 53, 48, 43, 38, 33, 28},
{54, 59, 64, 64, 59, 54, 49, 44, 39, 34, 29, 24},
{50, 55, 60, 60, 55, 50, 45, 40, 35, 30, 25, 20},
{46, 51, 56, 56, 51, 46, 41, 36, 31, 26, 21, 16}
};
