STFC-DDG/cosmic-ray-cube/(commit log)

2024-02-02 Prototype code upload
2024-02-02 Upload 3D print files
    [SiPM_clip.stl, TubeCollet.stl]
2024-02-02 3D print file upload
    [SiPM_clip.stl, TubeCollet.stl]
2024-02-06 PCB files upload
    [pc3860m1_BOM_Build_1.xlsx, pc3867p1_BOM_Build_1.xlsx]
